davidpalma666/device.faststepper_FORK/_FastStepper notes.txt

https://www.altium365.com/viewer/

https://www.wandkey.com/usb-c-pinout-guide-and-features/

*************************************************
*	@26 Agosto 2025

>> FastStepper
		. em espera de nova board com microUSB corrigido

		Filipe @15 Agosto
			. David's fork for future reference: https://github.com/davidpalma666/device.faststepper_FORK
			.A PCB ja está em produção! Fica aqui a nota que fica a faltar a BOM.		!!!!!!!!!!!!!!!!!!!!!!!!!!!!!!!!!!!!!!!!!!!!!!!!
			. Ficheiros produzidos: https://github.com/harp-tech/device.faststepper/tree/b39326d0b987731fd0d6c8d6e952e8dfe8ec6d94

*************************************************
*	@8 Agosto 2025

- erros na v.1.0
	. fich USB-C; pinos B10 & B11 com rails de clock errados
		- B10 = CLCK_N
		- B11 = CLCK_P			OK
	. Rs de PDown nos rails USB CC1 & CC2
	. rail de VClck deixa de existir: VClck = +3V3

*************************************************
*	@6 Agosto 2025

- projecto fw FastStepper.atsln compila mas não funciona
- projecto fw VestibularH2.atsln compila e funciona
	para teste:
		Bonsai: \Assests\VestibularVrH2_tests.bonsai

*************************************************
*	@4 Agosto 2025

>> PINOS USB CC1 & CC2 MAL LIGADOS!!!!!
	>>TÊM DE SER COM PDOWN ~5K; ESTÃO NO AR

>> dúvidas para mais testes...
	- herança a partir do projecto Vestibular VrH2 v1.1
	- motor stepper externo: NEMA23	 (??certo??)
		
	- motor sem own-driver; a board tb não faz driver (sem Iout alta)

*************************************************
*	@25 Julho 2025

> comentários do Ricardo enquanto assembling:
	conn X3:
		. 3 pads mas são 2; PN errada(?)
		. ; é para assembling??

* * * * * * * * * * * * * * * * * * * * * * * * * * * * * * * * * * * * * * * * * * * * * * * * * * * 
*	@18 Junho 2025
*

>> desenho & colocação do screw terminal
	https://uk.rs-online.com/web/p/screw-terminals/6142425?gb=s
	Mfr. Part No.:7689
	Brand: Keystone
	de refª pelo Tarquino - parafuso na Horizontal
		- não daria mais jeito parafuso na vertical? MPN: 7698

>> da reunião hoje com a Neurogears
	- colocar caps perto da ficha do motor
	- harp-Clock out tb na ficha X1
	- furos mecânicos da PCB Grouded

* * * * * * * * * * * * * * * * * * * * * * * * * * * * * * * * * * * * * * * * * * * * * * * * * * * 
*	@17 Junho 2025
*

>> qual é o MPN do jack??
		PJ-316A-6A
		3.5mm headphone jack 235? 30V 500mA SMD Audio Connector
		https://lcsc.com/product-detail/Audio-Connectors_Korean-Hroparts-Elec-PJ-316A-6A_C128987.html

>> tá lá ficha USB C - qual o pinout a utilizar?
	MPN do q está no projecto Altium
	MPN:
		TYPEC-324G-BCP24
		USB 3.1 5A 1 260℃ Surface Mount，Right Angle 24P 
		Female -45℃~+85℃ Type-C SMD USB Connectors
	Footprint:
		TYPEC-24P
		USB 3.1 5A Surface Mount, Right Angle 24P Female Type-C SMD USB Connectors
	>> sem este MPN nos fornecedores habituais Digk, Mouser, farnell

	escolhidos:
		#1
			Amphenol_12401610E4-2A
			Connector_USB:USB_C_Receptacle_
				Amphenol 12401610E4-2A
			digikey: 0
			Mouser: 10k
			Farnell: 8k
			1€
			!!!!!!! O ESCOLHIDO !!!!!!!!!!!
		
		#2
			Amphenol 10152803-00011LF
			digikey: 17k
			farnell: sob encomenda
			mouser: 8k
			1€
		
		#3
			GCT USB4056-03-A
			digikey: 8k
			farnell: 2k
			mouser: 17k
			0.9€

* * * * * * * * * * * * * * * * * * * * * * * * * * * * * * * * * * * * * * * * * * * * * * * * * * * 
*	@29 Abril 2025
*

> 1ª reunião sobre 'o a fazer neste projecto' com a Neurogears 
> perparar/delinear a seguir tempo/calendário das coisas, para orçamentar e formalizar o projecto

>>	Projecto FastStepper	<<

- trocar ficha USB por uma ficha USB-C
- ficha USB-C fica com suporte para clock incorporado, como existe atualmente no hub. 
	>> tá lá ficha USB C - qual o pinout a utilizar?

- Isto implicará trocar o jack de clock para um que permita detetar se existe uma ficha ligada ou não.
- circuito de autatic-select enviado em Altium
	OK ??

- colocar o novo jack de clock ao lado da ficha USB, para que as ligações externas ao sistema estejam todas do mesmo lado. 
Podemos dar mais espaço entre as várias fichas visto que a placa cresceu um bocado e temos bastante espaço para distrubuir as fichas do lado direito.
		OK ??

- acrescentar pull-ups opcionais de 10K com um solder jumper nas entradas ENDSTOP, IN0 e IN1	OK

- adicionar um buffer à entrada do emergency input.		OK

- ficha X1:
- Adicionar buffers às ligações RX, TX e clock da ficha X1. 	OK

- Ligar o pino 1 da ficha X1 aos 5V da placa e remover o jack DC que existe atualmente.		OK
- remover o jack DC que existe atualmente.		OK

- A DISPONIBILIDADE DE CLCK NA FICHA PASSA POR UM R0		OK

- Colocar buracos de fixação nos 4 cantos da placa e dar um espaço maior entre os buracos e as fichas quando possível.

- Acrescentar um screw terminal com ligação a ground. Algo deste tipo: https://uk.rs-online.com/web/p/screw-terminals/6142425?gb=s

>> timeline para FastStepper
- migração de  plataforma do projecto Eagle->Kicad		~1dia
- desenho de novos elementos no esquemático & nova alocação na PCB 	~2dias
- 1ª reunião de revisão com NeuroGears 	~1/2 dia
- re-desenho & routing já fino para objecto final 	~2dias
- 2ª reunião de revisão com NeuroGears 	~1/2dia
- colmatar das últimas revisões feitas 	~2dias
