davidpalma666/device.faststepper_FORK/(commit log)

2025-05-30 FastStepper - Kicad migrated from Eagle
    -1st step on Kicad from Eagle migration; original project: device.vestibular.H2 project
    - no changes on schematic design nor PCB
    - schematic got to have 3 pages for easy reading & printing
    - project own Symbol & PCB libs created
    - DRC=0; only Warnings about SilkScreen positions
    - added auxiliar projects folder for next step on design
    [Clock Buffer.SchDoc, Clock Input.SchDoc, Clock Thru.SchDoc, DC SEPIC.SchDoc, FastStepper.kicad_pcb, FastStepper.kicad_sch, IO stage_1.kicad_sch, MOS Switch.SchDoc]
2025-06-12 passo intermédio
    [FastStepper.kicad_pcb, FastStepper.kicad_sch, IO stage_1.kicad_sch, USB Clock stage.kicad_sch, VestibularH2.kicad_pcb, VestibularH2.kicad_sch, core stage.kicad_sch, harp Clock.kicad_sch]
2025-06-17 FastStepper DRC=0
    DRC=0
    ainda não revisto com mais ninguém
    [FastStepper.kicad_pcb, FastStepper.kicad_sch, harp Clock.kicad_sch]
2025-06-18 ver comentarios no .txt
    [FastStepper.kicad_pcb, FastStepper.kicad_sch, IO stage_1.kicad_sch, core stage.kicad_sch, harp Clock.kicad_sch]
2025-06-23 DRC=0; mudanças faladas com Neurogears @12Junho OK
    [FastStepper.kicad_pcb, FastStepper.kicad_sch, IO stage_1.kicad_sch]
2025-06-23 adicionados ficheiros Gerbers&Drills
    [FastStepper-B_Cu.gbr, FastStepper-B_Mask.gbr, FastStepper-B_Paste.gbr, FastStepper-B_Silkscreen.gbr, FastStepper-Edge_Cuts.gbr, FastStepper-F_Cu.gbr, FastStepper-F_Mask.gbr, FastStepper-F_Paste.gbr]
2025-06-23 MPN & OEPSPN adicionados; ainda em falta novos PNs a ser emitidos
    [FastStepper.kicad_pcb, FastStepper.kicad_sch, IO stage_1.kicad_sch, core stage.kicad_sch, harp Clock.kicad_sch]
2025-07-04 MPN & OEPSPN concluded
    concluded but not yet certified
    [FastStepper.kicad_pcb, FastStepper.kicad_sch, IO stage_1.kicad_sch, core stage.kicad_sch, harp Clock.kicad_sch]
2025-07-08 OEPSPN & MPN corrected
    [FastStepper.kicad_pcb, FastStepper.kicad_sch, harp Clock.kicad_sch]
2025-07-08 updated Gerbers & P&P & BOM
    [BOM.xlsx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]
2025-07-09 getting tunned with Main Commit on Jul 9, 2025
    [BOM.xlsx, FastStepper.csv]
2025-07-10 fine tunning
    - fine position adjust on X1 plug
    - Top & Bott Fabrication Layers 'cleaned' - can be used on production
    - generated new Gerbers & Drill files
    - BOM & Pick&Place stand as it were
    [FastStepper-B_Cu.gbr, FastStepper-B_Fab.gbr, FastStepper-B_Mask.gbr, FastStepper-B_Paste.gbr, FastStepper-B_Silkscreen.gbr, FastStepper-Edge_Cuts.gbr, FastStepper-F_Cu.gbr, FastStepper-F_Fab.gbr]
2025-07-11 tunning de tracks & vias por exegse da Eurocircuits
    Para ser produzível por Eurocircuits:
    - vias redimensionadas
    - pequenos movimentos de movimentos de tracks & vias - não houve movimento componentes
    - gerados Gerbers & PTH & NPTH
    - P&P como estava
    [FastStepper-B_Cu.gbr, FastStepper-B_Fab.gbr, FastStepper-B_Mask.gbr, FastStepper-B_Paste.gbr, FastStepper-B_Silkscreen.gbr, FastStepper-Edge_Cuts.gbr, FastStepper-F_Cu.gbr, FastStepper-F_Fab.gbr]
2025-07-11 mesmo tema q o commit anterior
    - estavam ficheiros do projecto abertos - não há garantia de commit 100% OK!!
2025-07-11 fine tunning on USB plug
    [FastStepper-B_Cu.gbr, FastStepper-B_Fab.gbr, FastStepper-B_Mask.gbr, FastStepper-B_Paste.gbr, FastStepper-B_Silkscreen.gbr, FastStepper-Edge_Cuts.gbr, FastStepper-F_Cu.gbr, FastStepper-F_Fab.gbr]
2025-07-11 fine tunning on USB plug II
    [FastStepper-B_Cu.gbr, FastStepper-B_Fab.gbr, FastStepper-B_Mask.gbr, FastStepper-B_Paste.gbr, FastStepper-B_Silkscreen.gbr, FastStepper-Edge_Cuts.gbr, FastStepper-F_Cu.gbr, FastStepper-F_Fab.gbr]
2025-08-08 inicio de redesenho v.1.1
    [BOM.xlsx, Clock Buffer.SchDoc, Clock Input.SchDoc, Clock Thru.SchDoc, DC SEPIC.SchDoc, FastStepper.kicad_pcb, FastStepper.kicad_sch, IO stage_1.kicad_sch]
2025-08-08 1º commit com v.1.1 corrigida
    . fich USB-C; pinos B10 & B11 trocados
    . Rs de PDown nos rails USB CC1 & CC2
    . rail de VClck deixa de existir: VClck = +3V3
    [FastStepper-B_Cu.gbr, FastStepper-B_Fab.gbr, FastStepper-B_Mask.gbr, FastStepper-B_Paste.gbr, FastStepper-B_Silkscreen.gbr, FastStepper-Edge_Cuts.gbr, FastStepper-F_Cu.gbr, FastStepper-F_Fab.gbr]
2025-08-26 sincronia com v.1.1 de main
    [BOM.xlsx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]
