davidpalma666/device.faststepper_FORK/Hardware/PCB/FastStepper.kicad_pcb

## KiCad design Hardware/PCB/FastStepper.kicad_pcb (2025-08-26)

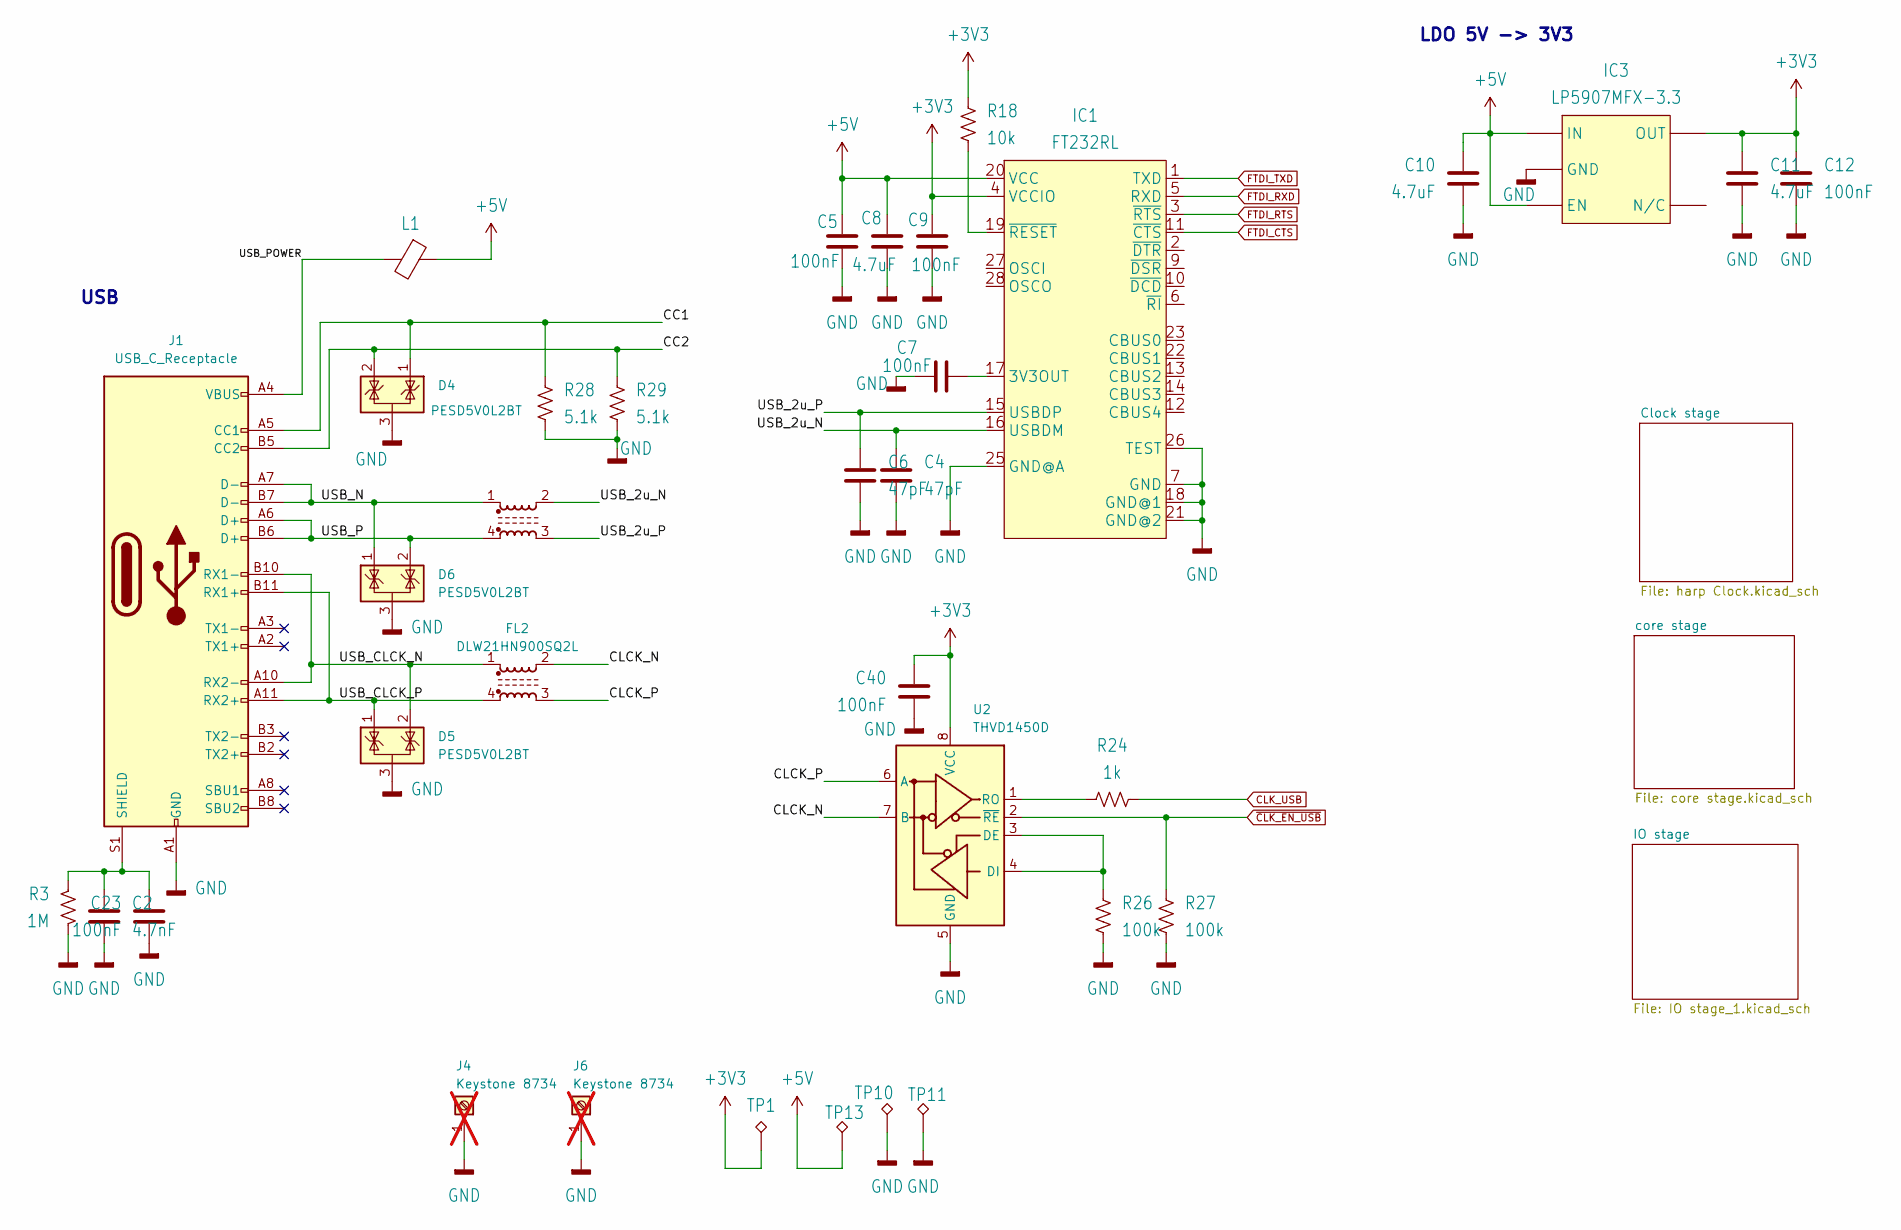
[picture p1: schematic FastStepper.kicad_sch]

Parts:
C2: 4.7nF; C_0402_1005Metric; MPN 885012205084
C4, C6: 47pF; C_0402_1005Metric; MPN 04025A470JAT2A
C5, C7, C9, C12, C23, C40: 100nF; C_0402_1005Metric; MPN CGA2B3X7R1H104K050BB
C8, C10, C11: 4.7uF; C_0603_1608Metric; MPN C1608X6S1C475K080AC
D4, D5, D6: PESD5V0L2BT; SOT-23; MPN PESD5V0L2BT,215
FL1, FL2: DLW21HN900SQ2L; FIL_DLW21HN900SQ2L; MPN DLW21HN900SQ2L
IC1: FT232RL; SSOP-28_5.3x10.2mm_P0.65mm; MPN FT232RNL-REEL
IC3: LP5907MFX-3.3; TSOT-23-5; MPN LP5907MFX-3.3/NOPB
J1: USB_C_Receptacle; USB_C_Receptacle_Amphenol_12401610E4-2A; MPN 12401610E4#2A
J4, J6: Keystone 8734; Terminal_Block_Keystone_8734_1x01_Horizontal_Screw; MPN 8734; not fitted
L1: 40R@100MHz; R_0805_2012Metric; MPN MI0805K400R-10
R3: 1M; R_0402_1005Metric; MPN CRCW04021M00FKED
R18: 10k; R_0402_1005Metric; MPN ERJ-2RKF1002X
R24: 1k; R_0402_1005Metric; MPN ERJ-2RKF1001X
R26, R27: 100k; R_0402_1005Metric; MPN ERJ-2RKF1003X
R28, R29: 5.1k; R_0402_1005Metric; MPN ERJ-2RKF5101X
TP1, TP10, TP11, TP13: NO_COMPONENT; TestPoint_THTPad_D1.0mm_Drill0.5mm
U2: THVD1450D; SOIC-8_3.9x4.9mm_P1.27mm; MPN THVD1450D

Connections:
+3V3: C9.1, C11.1, C12.1, C40.1, IC1.4 (VCCIO), IC3.5 (OUT), R18.2, TP1.1, U2.8 (VCC); also elsewhere on the board
+5V: C5.1, C8.1, C10.1, IC1.20 (VCC), IC3.1 (IN), IC3.3 (EN), L1.1, TP13.1; also elsewhere on the board
/CC1: D4.1 (K), J1.A5 (CC1), R28.1
/CC2: D4.2 (K), J1.B5 (CC2), R29.1
/CLCK_N: FL2.2, U2.7 (B)
/CLCK_P: FL2.3, U2.6 (A)
/USB_2u_N: C4.1, FL1.2, IC1.16 (USBDM)
/USB_2u_P: C6.1, FL1.3, IC1.15 (USBDP)
/USB_CLCK_N: D5.2 (K), FL2.1, J1.A10 (RX2-), J1.B10 (RX1-)
/USB_CLCK_P: D5.1 (K), FL2.4, J1.A11 (RX2+), J1.B11 (RX1+)
/USB_N: D6.1 (K), FL1.1, J1.A7 (D-), J1.B7 (D-)
/USB_P: D6.2 (K), FL1.4, J1.A6 (D+), J1.B6 (D+)
/USB_POWER: J1.A4 (VBUS), J1.A9 (VBUS), J1.B4 (VBUS), J1.B9 (VBUS), L1.2
CLK_USB: R24.1; also elsewhere on the board
FTDI_CTS: IC1.11 (~CTS); also elsewhere on the board
FTDI_RTS: IC1.3 (~RTS); also elsewhere on the board
FTDI_RXD: IC1.5 (RXD); also elsewhere on the board
FTDI_TXD: IC1.1 (TXD); also elsewhere on the board
GND: C2.2, C4.2, C5.2, C6.2, C7.2, C8.2, C9.2, C10.2, C11.2, C12.2, C23.1, C40.2, D4.3 (A), D5.3 (A), D6.3 (A), IC1.7 (GND), IC1.18 (GND@1), IC1.21 (GND@2), IC1.25 (GND@A), IC1.26 (TEST), IC3.2 (GND), J1.A1 (GND), J1.A12 (GND), J1.B1 (GND), J1.B12 (GND), J4.1, J6.1, R3.1, R26.2, R27.2, R28.2, R29.2, TP10.1, TP11.1, U2.5 (GND); also elsewhere on the board
unnamed: C7.1, IC1.17 (3V3OUT)
unnamed: IC1.19 (~RESET), R18.1
unnamed: C2.1, C23.2, J1.S1 (SHIELD), R3.2
unnamed: R26.1, U2.3 (DE), U2.4 (DI)
unnamed: R24.2, U2.1 (RO)
~CLK_EN_USB: R27.1, U2.2 (~RE); also elsewhere on the board

Notes on the sheet:
USB
LDO 5V -> 3V3

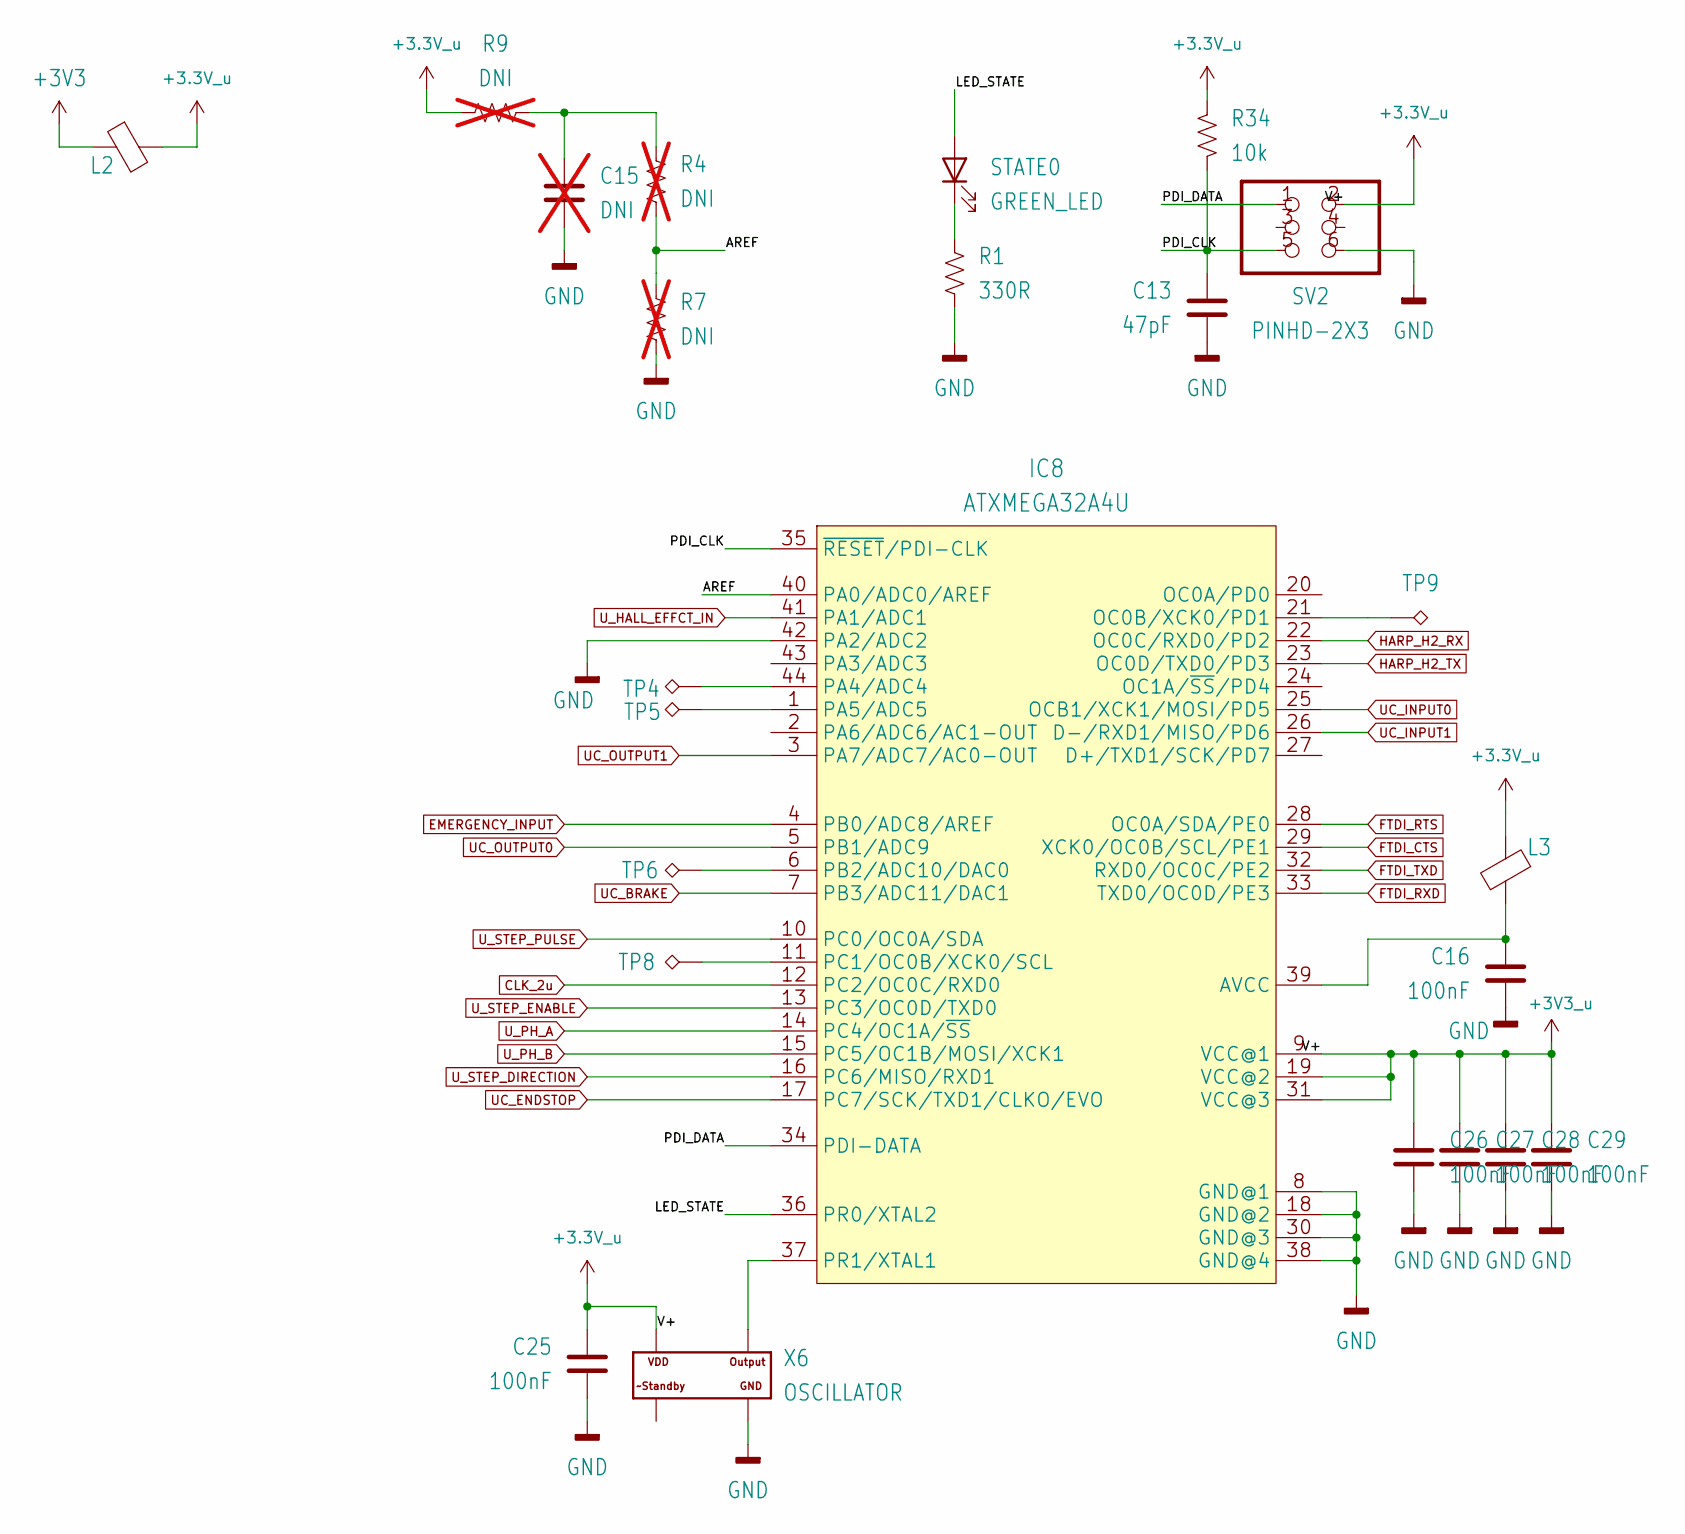
[picture p2: schematic core stage.kicad_sch]

Parts:
C13: 47pF; C_0402_1005Metric; MPN 04025A470JAT2A
C15: DNI; C_0603_1608Metric; MPN n.a.; not fitted
C16, C25, C26, C27, C28, C29: 100nF; C_0402_1005Metric; MPN CGA2B3X7R1H104K050BB
IC8: ATXMEGA32A4U; TQFP-44_10x10mm_P0.8mm; MPN ATXMEGA32A4U-A
L2, L3: 40R@100MHz; R_0805_2012Metric; MPN MI0805K400R-10
R1: 330R; R_0402_1005Metric; MPN RC0402FR-07330RL
R4, R7, R9: DNI; R_0402_1005Metric; MPN n.a.; not fitted
R34: 10k; R_0402_1005Metric; MPN ERJ-2RKF1002X
STATE0: GREEN_LED; LED_0603_1608Metric; MPN LTST-C191KGKT
SV2: PINHD-2X3; PinHeader_2x03_P2.54mm_Vertical; MPN PR20203VBDN
TP4, TP5, TP6, TP8, TP9: NO_COMPONENT; TestPoint_THTPad_D1.0mm_Drill0.5mm
X6: OSCILLATOR; Oscillator_SMD_Abracon_ASE-4Pin_3.2x2.5mm; MPN DSC1001CI5-032.0000

Connections:
+3.3V_u: C25.1, C26.1, C27.1, C28.1, C29.1, IC8.9 (VCC@1), IC8.19 (VCC@2), IC8.31 (VCC@3), L2.2, L3.1, R9.2, R34.1, SV2.2, X6.4 (VDD); also elsewhere on the board
+3V3: L2.1; also elsewhere on the board
/core stage/AREF: IC8.40 (PA0/ADC0/AREF), R4.1, R7.2
/core stage/LED_STATE: IC8.36 (PR0/XTAL2), STATE0.2 (A)
/core stage/PDI_CLK: C13.1, IC8.35 (~RESET/PDI-CLK), R34.2, SV2.5
/core stage/PDI_DATA: IC8.34 (PDI-DATA), SV2.1
CLK_2u: IC8.12 (PC2/OC0C/RXD0); also elsewhere on the board
EMERGENCY_INPUT: IC8.4 (PB0/ADC8/AREF); also elsewhere on the board
FTDI_CTS: IC8.29 (XCK0/OC0B/SCL/PE1); also elsewhere on the board
FTDI_RTS: IC8.28 (OC0A/SDA/PE0); also elsewhere on the board
FTDI_RXD: IC8.33 (TXD0/OC0D/PE3); also elsewhere on the board
FTDI_TXD: IC8.32 (RXD0/OC0C/PE2); also elsewhere on the board
GND: C13.2, C15.2, C16.2, C25.2, C26.2, C27.2, C28.2, C29.2, IC8.8 (GND@1), IC8.18 (GND@2), IC8.30 (GND@3), IC8.38 (GND@4), IC8.42 (PA2/ADC2), R1.1, R7.1, SV2.6, X6.2 (GND); also elsewhere on the board
HARP_H2_RX: IC8.22 (OC0C/RXD0/PD2); also elsewhere on the board
HARP_H2_TX: IC8.23 (OC0D/TXD0/PD3); also elsewhere on the board
unnamed: C15.1, R4.2, R9.1
unnamed: C16.1, IC8.39 (AVCC), L3.2
unnamed: IC8.21 (OC0B/XCK0/PD1), TP9.1
unnamed: IC8.44 (PA4/ADC4), TP4.1
unnamed: IC8.1 (PA5/ADC5), TP5.1
unnamed: IC8.6 (PB2/ADC10/DAC0), TP6.1
unnamed: IC8.11 (PC1/OC0B/XCK0/SCL), TP8.1
unnamed: IC8.37 (PR1/XTAL1), X6.3 (OUTPUT)
unnamed: R1.2, STATE0.1 (K)
UC_BRAKE: IC8.7 (PB3/ADC11/DAC1); also elsewhere on the board
UC_ENDSTOP: IC8.17 (PC7/SCK/TXD1/CLKO/EVO); also elsewhere on the board
UC_INPUT0: IC8.25 (OCB1/XCK1/MOSI/PD5); also elsewhere on the board
UC_INPUT1: IC8.26 (D-/RXD1/MISO/PD6); also elsewhere on the board
UC_OUTPUT0: IC8.5 (PB1/ADC9); also elsewhere on the board
UC_OUTPUT1: IC8.3 (PA7/ADC7/AC0-OUT); also elsewhere on the board
U_HALL_EFFCT_IN: IC8.41 (PA1/ADC1); also elsewhere on the board
U_PH_A: IC8.14 (PC4/OC1A/~SS); also elsewhere on the board
U_PH_B: IC8.15 (PC5/OC1B/MOSI/XCK1); also elsewhere on the board
U_STEP_DIRECTION: IC8.16 (PC6/MISO/RXD1); also elsewhere on the board
U_STEP_ENABLE: IC8.13 (PC3/OC0D/TXD0); also elsewhere on the board
U_STEP_PULSE: IC8.10 (PC0/OC0A/SDA); also elsewhere on the board

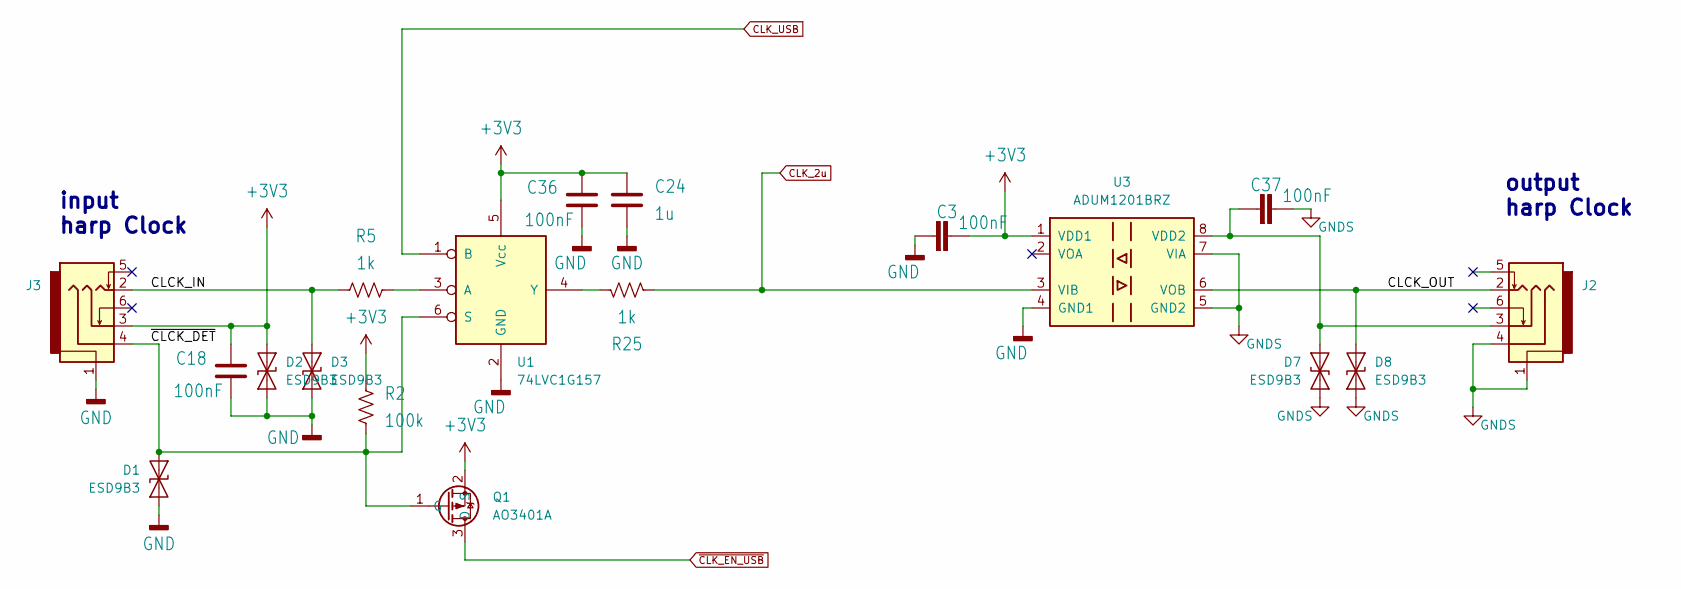
[picture p3: schematic harp Clock.kicad_sch]

Parts:
C3, C18, C36, C37: 100nF; C_0402_1005Metric; MPN CGA2B3X7R1H104K050BB
C24: 1u; C_0603_1608Metric; MPN CL10A105KA8NNNC
D1, D2, D3, D7, D8: ESD9B3; D_SOD-923; MPN ESD9B3.3ST5G
J2, J3: PJ-316A-6A; Jack_3.5mm_PJ316A_Horizontal; MPN PJ-316A-6A
Q1: AO3401A; TSOT-23; MPN AO3401A
R2: 100k; R_0402_1005Metric; MPN ERJ-2RKF1003X
R5, R25: 1k; R_0402_1005Metric; MPN ERJ-2RKF1001X
U1: 74LVC1G157; TSOP-6_1.65x3.05mm_P0.95mm; MPN 74LVC1G157GV,125
U3: ADUM1201BRZ; SOIC-8_3.9x4.9mm_P1.27mm; MPN ADUM1201BRZ

Connections:
+3V3: C3.2, C18.2, C24.1, C36.2, D2.2 (A2), J3.3, Q1.2 (S), R2.1, U1.5 (Vcc), U3.1 (VDD1); also elsewhere on the board
/Clock stage/CLCK_IN: D3.2 (A2), J3.2, R5.2
/Clock stage/CLCK_OUT: D8.2 (A2), J2.2, U3.6 (VOB)
/Clock stage/~CLCK_DET: D1.2 (A2), J3.4, Q1.1 (G), R2.2, U1.6 (S)
CLK_2u: R25.1, U3.3 (VIB); also elsewhere on the board
CLK_USB: U1.1 (B); also elsewhere on the board
GND: C3.1, C18.1, C24.2, C36.1, D1.1 (A1), D2.1 (A1), D3.1 (A1), J3.1, U1.2 (GND), U3.4 (GND1); also elsewhere on the board
GNDS: C37.2, D7.1 (A1), D8.1 (A1), J2.1, J2.4, U3.5 (GND2), U3.7 (VIA)
unnamed: C37.1, D7.2 (A2), J2.3, U3.8 (VDD2)
unnamed: R5.1, U1.3 (A)
unnamed: R25.2, U1.4 (Y)
~CLK_EN_USB: Q1.3 (D); also elsewhere on the board

Notes on the sheet:
output harp Clock
input harp Clock

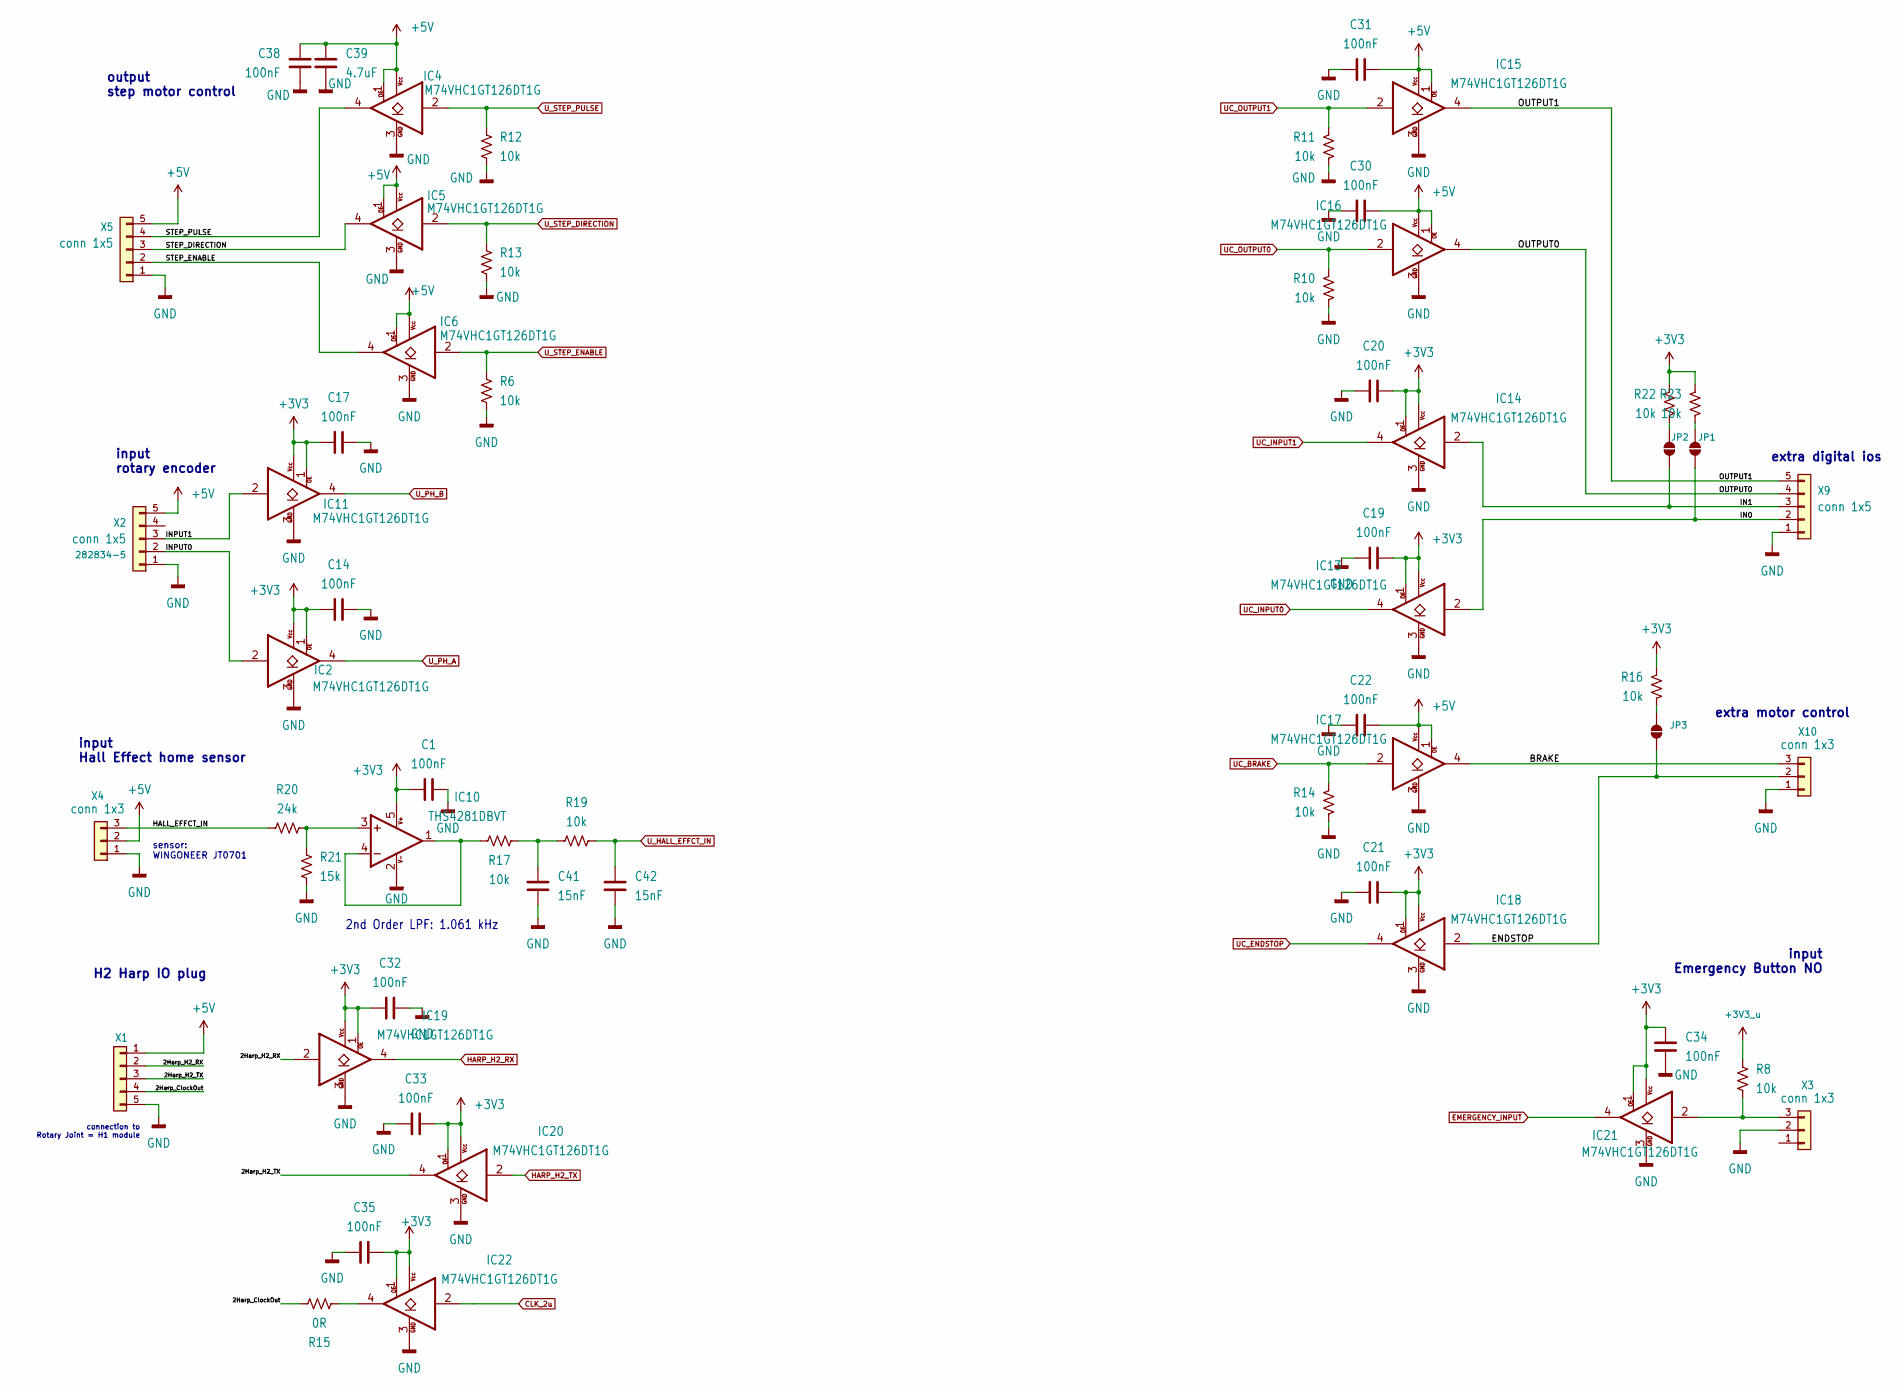
[picture p4: schematic IO stage_1.kicad_sch]

Parts:
C1, C14, C17, C19, C20, C21, C22, C30, C31, C32, C33, C34, C35, C38: 100nF; C_0402_1005Metric; MPN CGA2B3X7R1H104K050BB
C39: 4.7uF; C_0603_1608Metric; MPN C1608X6S1C475K080AC
C41, C42: 15nF; C_0402_1005Metric; MPN CGA2B3X7R1V153K050BB
IC2, IC4, IC5, IC6, IC11, IC13, IC14, IC15, IC16, IC17, IC18, IC19, IC20, IC21, IC22: M74VHC1GT126DT1G; TSOP-5_1.65x3.05mm_P0.95mm; MPN M74VHC1GT126DT1G
IC10: THS4281DBVT; SOT-23-5; MPN THS4281DBVT
JP1, JP2, JP3: SolderJumper_2_Open; SolderJumper-2_P1.3mm_Open_RoundedPad1.0x1.5mm
R6, R8, R10, R11, R12, R13, R14, R16, R17, R19, R22, R23: 10k; R_0402_1005Metric; MPN ERJ-2RKF1002X
R15: 0R; R_0402_1005Metric; MPN RC0402JR-070RL
R20: 24k; R_0402_1005Metric; MPN ERJ-2RKF2402X
R21: 15k; R_0402_1005Metric; MPN ERJ-2RKF1502X
X1: conn 1x5 2; 20_155MH_5; MPN 20.155MH/5-E
X2, X5, X9: conn 1x5; 22-23-2051; MPN 282834-5
X3, X4, X10: conn 1x3; 22-23-2031; MPN 282834-3

Connections:
+3.3V_u: R8.2; also elsewhere on the board
+3V3: C1.1, C14.1, C17.1, C19.1, C20.1, C21.1, C32.1, C33.1, C34.1, C35.1, IC2.1 (OE), IC2.5 (VCC), IC10.5 (V+), IC11.1 (OE), IC11.5 (VCC), IC13.1 (OE), IC13.5 (VCC), IC14.1 (OE), IC14.5 (VCC), IC18.1 (OE), IC18.5 (VCC), IC19.1 (OE), IC19.5 (VCC), IC20.1 (OE), IC20.5 (VCC), IC21.1 (OE), IC21.5 (VCC), IC22.1 (OE), IC22.5 (VCC), R16.2, R22.2, R23.2; also elsewhere on the board
+5V: C22.1, C30.1, C31.1, C38.2, C39.1, IC4.1 (OE), IC4.5 (VCC), IC5.1 (OE), IC5.5 (VCC), IC6.1 (OE), IC6.5 (VCC), IC15.1 (OE), IC15.5 (VCC), IC16.1 (OE), IC16.5 (VCC), IC17.1 (OE), IC17.5 (VCC), X1.1, X2.5, X4.2, X5.5; also elsewhere on the board
/IO stage/2Harp_ClockOut: R15.2, X1.4
/IO stage/2Harp_H2_RX: IC19.2 (A), X1.2
/IO stage/2Harp_H2_TX: IC20.4 (Y), X1.3
/IO stage/BRAKE: IC17.4 (Y), X10.3
/IO stage/ENDSTOP: IC18.2 (A), JP3.1 (A), X10.2
/IO stage/HALL_EFFCT_IN: R20.2, X4.3
/IO stage/IN0: IC13.2 (A), JP1.1 (A), X9.2
/IO stage/IN1: IC14.2 (A), JP2.1 (A), X9.3
/IO stage/INPUT0: IC2.2 (A), X2.2
/IO stage/INPUT1: IC11.2 (A), X2.3
/IO stage/OUTPUT0: IC16.4 (Y), X9.4
/IO stage/OUTPUT1: IC15.4 (Y), X9.5
/IO stage/STEP_DIRECTION: IC5.4 (Y), X5.3
/IO stage/STEP_ENABLE: IC6.4 (Y), X5.2
/IO stage/STEP_PULSE: IC4.4 (Y), X5.4
CLK_2u: IC22.2 (A); also elsewhere on the board
EMERGENCY_INPUT: IC21.4 (Y); also elsewhere on the board
GND: C1.2, C14.2, C17.2, C19.2, C20.2, C21.2, C22.2, C30.2, C31.2, C32.2, C33.2, C34.2, C35.2, C38.1, C39.2, C41.1, C42.1, IC2.3 (GND), IC4.3 (GND), IC5.3 (GND), IC6.3 (GND), IC10.2 (V-), IC11.3 (GND), IC13.3 (GND), IC14.3 (GND), IC15.3 (GND), IC16.3 (GND), IC17.3 (GND), IC18.3 (GND), IC19.3 (GND), IC20.3 (GND), IC21.3 (GND), IC22.3 (GND), R6.1, R10.1, R11.1, R12.1, R13.1, R14.1, R21.1, X1.5, X2.1, X3.2, X4.1, X5.1, X9.1, X10.1; also elsewhere on the board
HARP_H2_RX: IC19.4 (Y); also elsewhere on the board
HARP_H2_TX: IC20.2 (A); also elsewhere on the board
unnamed: C41.2, R17.2, R19.1
unnamed: IC10.3 (+IN), R20.1, R21.2
unnamed: IC10.1 (OUT), IC10.4 (-IN), R17.1
unnamed: IC21.2 (A), R8.1, X3.3
unnamed: IC22.4 (Y), R15.1
unnamed: JP1.2 (B), R23.1
unnamed: JP2.2 (B), R22.1
unnamed: JP3.2 (B), R16.1
UC_BRAKE: IC17.2 (A), R14.2; also elsewhere on the board
UC_ENDSTOP: IC18.4 (Y); also elsewhere on the board
UC_INPUT0: IC13.4 (Y); also elsewhere on the board
UC_INPUT1: IC14.4 (Y); also elsewhere on the board
UC_OUTPUT0: IC16.2 (A), R10.2; also elsewhere on the board
UC_OUTPUT1: IC15.2 (A), R11.2; also elsewhere on the board
U_HALL_EFFCT_IN: C42.2, R19.2; also elsewhere on the board
U_PH_A: IC2.4 (Y); also elsewhere on the board
U_PH_B: IC11.4 (Y); also elsewhere on the board
U_STEP_DIRECTION: IC5.2 (A), R13.2; also elsewhere on the board
U_STEP_ENABLE: IC6.2 (A), R6.2; also elsewhere on the board
U_STEP_PULSE: IC4.2 (A), R12.2; also elsewhere on the board

Notes on the sheet:
input Emergency Button NO
input rotary encoder
output step motor control
extra motor control
sensor: WINGONEER JT0701
input Hall Effect home sensor
H2 Harp IO plug
connection to Rotary Joint = H1 module
2nd Order LPF: 1.061 kHz
extra digital ios

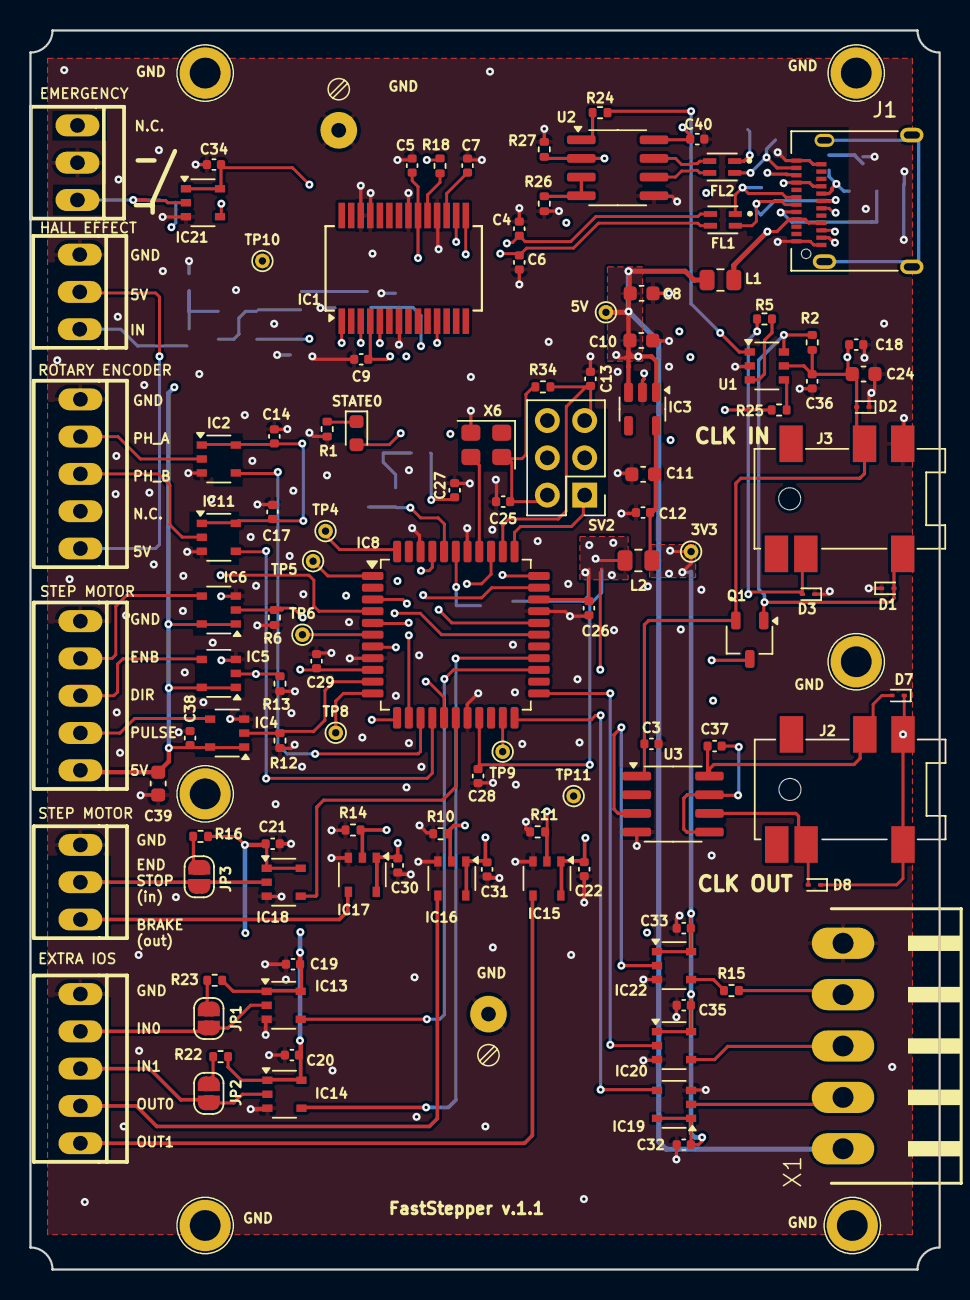
[picture p5: board FastStepper.kicad_pcb from above]

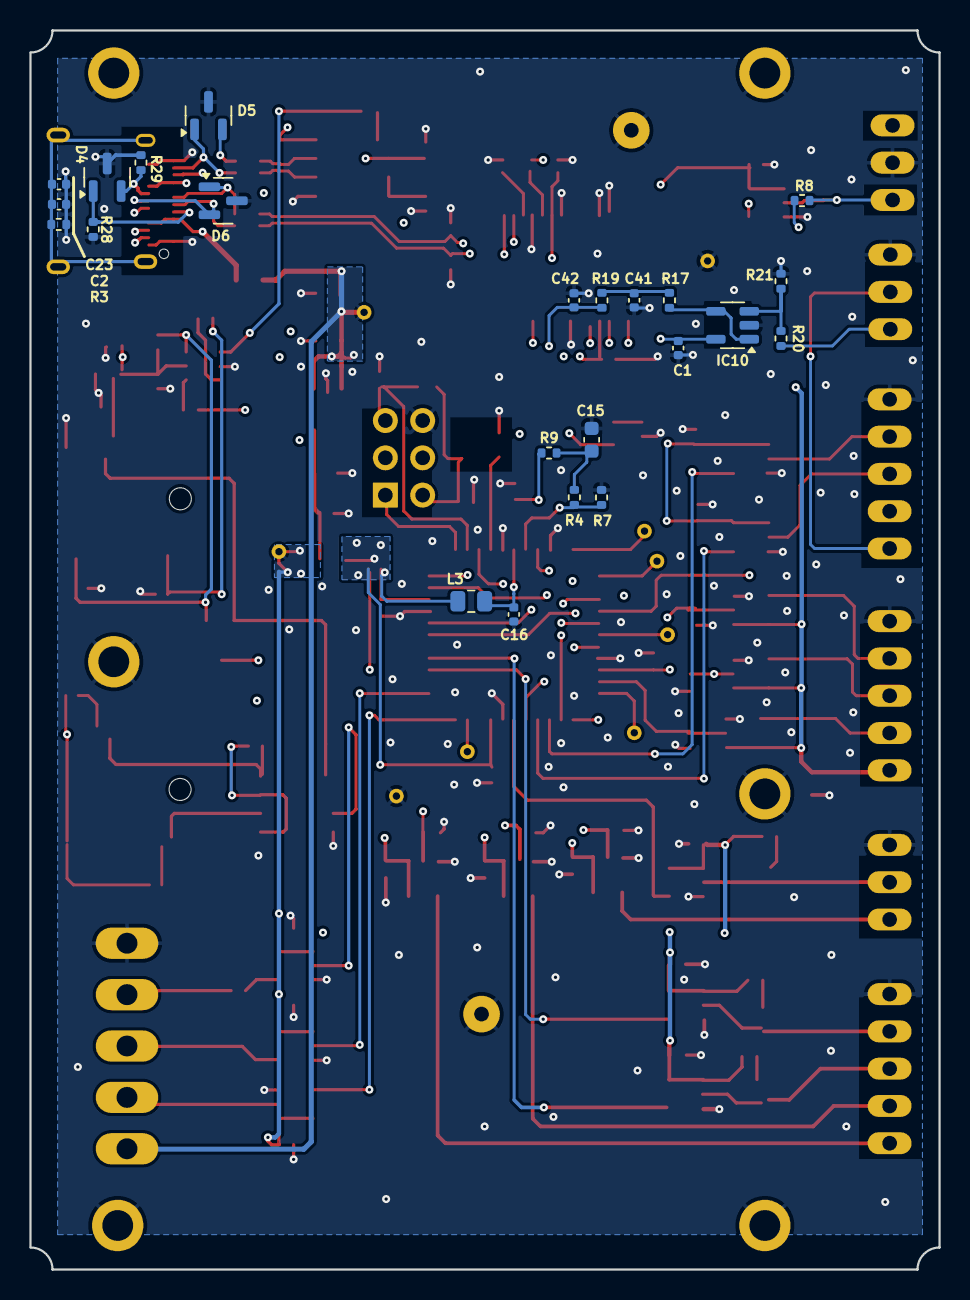
[picture p6: board FastStepper.kicad_pcb from below]

Board: 4 copper layers, 61.9 x 84.4 mm, 141 parts (23 on the bottom side), 85 nets.

Other parts of the board:
SC1, SC1#2, SC1#3, SC1#4, SC1#5, SC1#6: Pin_D4mm_hole2mm

Their connections:
GND: SC1.1, SC1#2.1, SC1#3.1, SC1#4.1, SC1#5.1, SC1#6.1; also elsewhere on the board
